NikitaKatrusch/rover/cad/referenz/Rover_V0_Bauraum.step

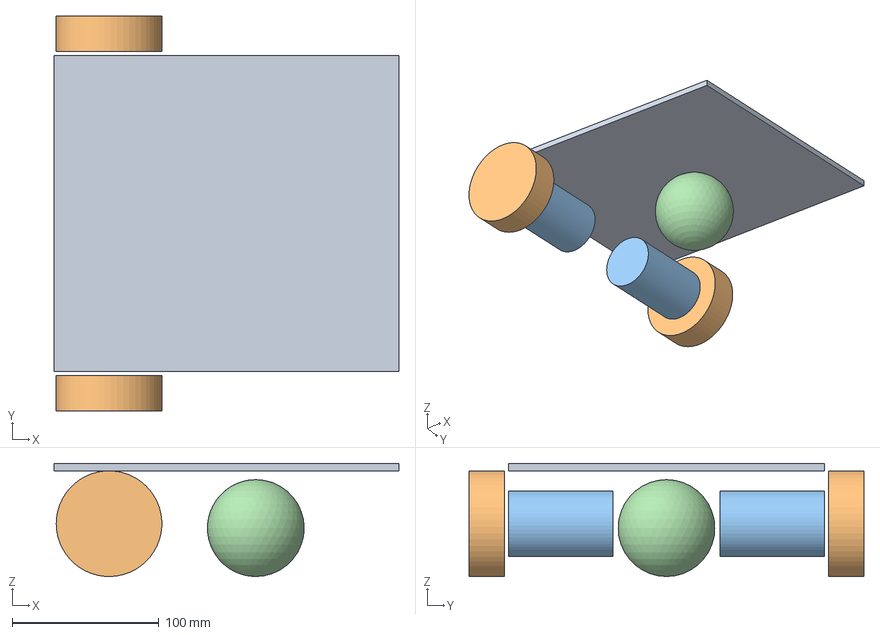
[picture p1: CAD file, 2026-11-07]
cad/referenz/Rover_V0_Bauraum.step
235.0 x 269.0 x 77.0 mm
