NikitaKatrusch/rover/cad/Schusskopf/Schusskopf_V0.3mf

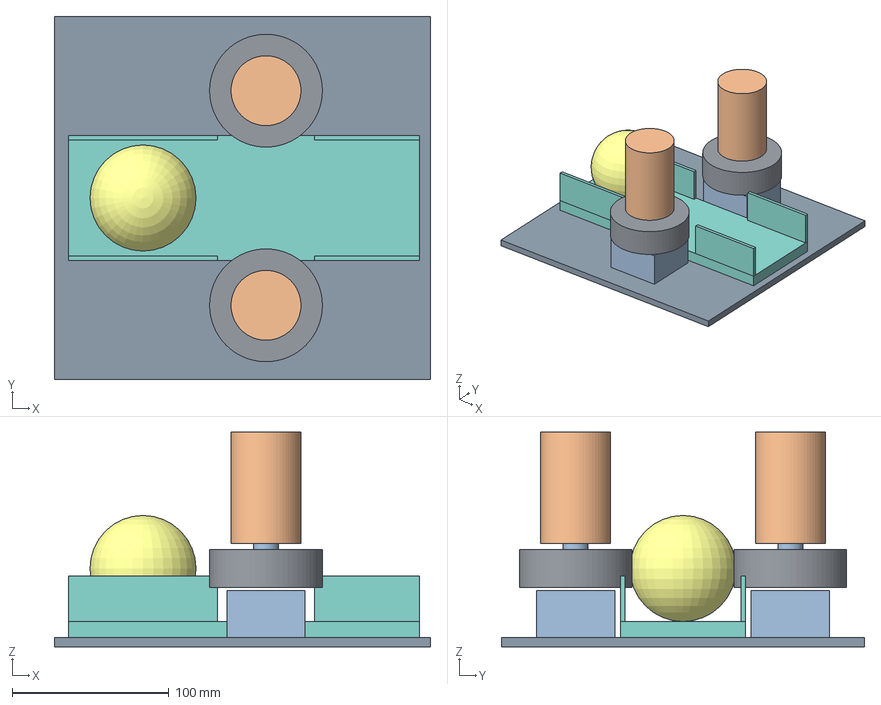
[picture p2: CAD file, 2026-11-07]
cad/Schusskopf/Schusskopf_V0.3mf
240.0 x 232.0 x 137.0 mm
01_Stationaere_Grundplatte_Bauraum
02_Durchgehende_Kanalsohle
02_Einlaufwand_R
02_Auslaufwand_R
03_Wurfrolle_Bauraum_R
04_Nabe_Bauraum_R
04_775_Motor_Bauraum_R
05_Schlittenposition_Bauraum_R
02_Einlaufwand_L
02_Auslaufwand_L
03_Wurfrolle_Bauraum_L
04_Nabe_Bauraum_L
04_775_Motor_Bauraum_L
05_Schlittenposition_Bauraum_L
00_Padelball_Maximalmass_Referenz
