NikitaKatrusch/rover/cad/v1/Rover_V1.3mf

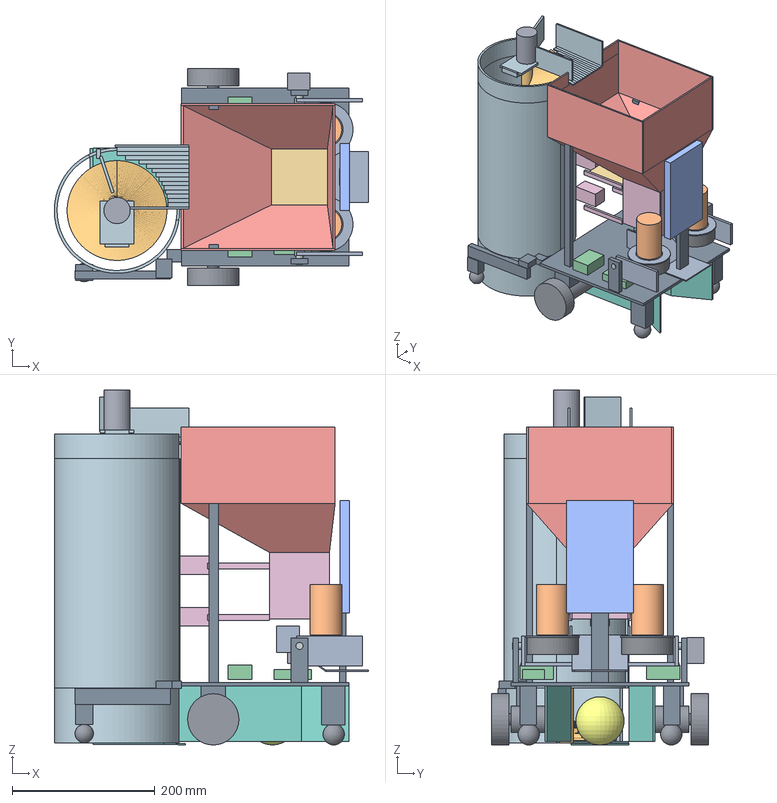
[picture p3: CAD file, 2026-11-07]
cad/v1/Rover_V1.3mf
441.0 x 304.0 x 498.0 mm
01_Grundplatte
01_Fahrrad_rechts
01_Getriebemotor_Bauraum_rechts
01_Radnabe_Bauraum_rechts
01_Motortraeger_rechts
02_Ballfuehrung_rechts_gerade
02_Ballfuehrung_rechts_Trichter
01_Stuetze_vorn_rechts
01_Kugelrolle_Bauraum_rechts
01_Fahrrad_links
01_Getriebemotor_Bauraum_links
01_Radnabe_Bauraum_links
01_Motortraeger_links
02_Ballfuehrung_links_gerade
02_Ballfuehrung_links_Trichter
01_Stuetze_vorn_links
01_Kugelrolle_Bauraum_links
02_Einlauframpe
02_Aufnahmetasche_Boden
02_Aufnahmetasche_Lippe
01_Hecktraeger
01_Hecktraeger_Querverbinder
01_Hecktraeger_Stuetzarm
01_Heckstuetze
01_Kipprolle_Bauraum
03_Schneckenwelle
03_Schnecke_Windung
03_Mantel_Einlauf
03_Mantel_Hauptschale
03_Mantel_Wartungsabdeckung
03_Mantel_Auslauf
03_Vertikalfuehrung_-1
03_Vertikalfuehrung_1
03_Wellenlager_Bauraum
03_Getriebemotor_Bauraum
03_Auflager_Schneckenmotor
03_Auslaufrutsche_Segment_0
03_Auslaufrutsche_Segment_6
03_Auslaufrutsche_Segment_12
03_Auslaufrutsche_Segment_18
03_Auslaufrutsche_Segment_24
03_Auslaufrutsche_Segment_30
03_Auslaufrutsche_Segment_36
03_Auslaufrutsche_Segment_42
03_Auslaufrutsche_Segment_48
03_Auslaufrutsche_Segment_54
03_Auslaufrutsche_Segment_60
03_Auslaufrutsche_Segment_66
03_Auslaufrutsche_Segment_72
03_Auslaufrutsche_Segment_78
03_Auslaufabstreifer
03_Auslaufwange_links
03_Auslaufwange_rechts
04_Trichter_unten
04_Speicher_vorn
04_Speicher_links
04_Speicher_rechts
04_Speicher_hinten_unten
04_Speicher_hinten_oben_-1
04_Trichterstuetze_-1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
