NikitaKatrusch/rover/(commit log)

2026-11-07 Document rear-auger rover and verify Fusion V0 reference assembly
2026-11-07 Build and verify complete FIP-sized Rover V1 digital assembly
2026-11-07 Verify Rover V1 Fusion import and add motor signal test bench
2026-11-07 Correct AliExpress product attribution to 775 motor
2026-11-07 Document shooter roller intake check and link purchased skate wheels
2026-11-08 Build motor-driven shooter in native MuJoCo MJCF
2026-11-08 Add printable tilt fit bench and 20 m padel lob simulation
2026-11-08 Show axle supports and full court in the lob viewer
2026-11-09 Add dimensional fit test for the 775 shaft and measured wheel core
2026-11-09 Add a faster P1S fit test for the 775 wheel adapter
2026-11-09 Print all three 775 fit gauges in a single setup
2026-11-10 Record fit-test failures and add reinforced 775 shaft gauges
2026-11-10 Bracket 775 shaft fit with one calibration strip and adapter
